Daniel-Loi/Spatial-Mapping-Embedded-System-/Keil_loid1/Main.c

/*  Time of Flight for 2DX4 -- Studio W8-0
Code written to support data collection from VL53L1X using the Ultra Light Driver.
I2C methods written based upon MSP432E4 Reference Manual Chapter 19.
Specific implementation was based upon format specified in VL53L1X.pdf pg19-21
Code organized according to en.STSW-IMG009\Example\Src\main.c

The VL53L1X is run with default firmware settings.


Written by Tom Doyle
Updated by  Hafez Mousavi Garmaroudi
Last Update: March 17, 2020

Last Update: March 03, 2022
Updated by Hafez Mousavi
__ the dev address can now be written in its original format.
Note: the functions  beginTxI2C and  beginRxI2C are modified in vl53l1_platform_2dx4.c file

 */
 # include <stdint.h>
 # include "tm4c1294ncpdt.h"
 # include "vl53l1x_api.h"
 # include "PLL.h"
 # include "SysTick.h"
 # include "uart.h"
 # include "onboardLEDs.h"

 # define I2C_MCS_ACK 0x00000008 // Data Acknowledge Enable
 # define I2C_MCS_DATACK 0x00000008 // Acknowledge Data
 # define I2C_MCS_ADRACK 0x00000004 // Acknowledge Address
 # define I2C_MCS_STOP 0x00000004 // Generate STOP
 # define I2C_MCS_START 0x00000002 // Generate START
 # define I2C_MCS_ERROR 0x00000002 // Error
 # define I2C_MCS_RUN 0x00000001 // I2C Master Enable
 # define I2C_MCS_BUSY 0x00000001 // I2C Busy
 # define I2C_MCR_MFE 0x00000010 // I2C Master Function Enable

 # define MAXRETRIES 5 // number of receive attempts before giving up
void I2C_Init(void) {
    SYSCTL_RCGCI2C_R |= SYSCTL_RCGCI2C_R0; // activate I2C0
    SYSCTL_RCGCGPIO_R |= SYSCTL_RCGCGPIO_R1; // activate port B
    while ((SYSCTL_PRGPIO_R & 0x0002) == 0) {}; // ready?

    GPIO_PORTB_AFSEL_R |= 0x0C; // 3) enable alt funct on PB2,3       0b00001100
    GPIO_PORTB_ODR_R |= 0x08; // 4) enable open drain on PB3 only

    GPIO_PORTB_DEN_R |= 0x0C; // 5) enable digital I/O on PB2,3
    //    GPIO_PORTB_AMSEL_R &= ~0x0C;          																// 7) disable analog functionality on PB2,3

    // 6) configure PB2,3 as I2C
    //  GPIO_PORTB_PCTL_R = (GPIO_PORTB_PCTL_R&0xFFFF00FF)+0x00003300;
    GPIO_PORTB_PCTL_R = (GPIO_PORTB_PCTL_R & 0xFFFF00FF) + 0x00002200; //TED
    I2C0_MCR_R = I2C_MCR_MFE; // 9) master function enable
    I2C0_MTPR_R = 0b0000000000000101000000000111011; // 8) configure for 100 kbps clock (added 8 clocks of glitch suppression ~50ns)
    //    I2C0_MTPR_R = 0x3B;                                        						// 8) configure for 100 kbps clock

}

//The VL53L1X needs to be reset using XSHUT.  We will use PG0
void PortG_Init(void) {
    //Use PortG0
    SYSCTL_RCGCGPIO_R |= SYSCTL_RCGCGPIO_R6; // activate clock for Port N
    while ((SYSCTL_PRGPIO_R & SYSCTL_PRGPIO_R6) == 0) {}; // allow time for clock to stabilize
    GPIO_PORTG_DIR_R &= 0x00; // make PG0 in (HiZ)
    GPIO_PORTG_AFSEL_R &= ~0x01; // disable alt funct on PG0
    GPIO_PORTG_DEN_R |= 0x01; // enable digital I/O on PG0
    // configure PG0 as GPIO
    //GPIO_PORTN_PCTL_R = (GPIO_PORTN_PCTL_R&0xFFFFFF00)+0x00000000;
    GPIO_PORTG_AMSEL_R &= ~0x01; // disable analog functionality on PN0

    return;
}

void PortH_Init(void) {
    //Use PORTH pins for output
    SYSCTL_RCGCGPIO_R |= SYSCTL_RCGCGPIO_R7; // activate clock for Port N
    while ((SYSCTL_PRGPIO_R & SYSCTL_PRGPIO_R7) == 0) {}; // allow time for clock to stabilize
    GPIO_PORTH_DIR_R |= 0xFF; // make PN0 out (PN0 built-in LED1)
    GPIO_PORTH_AFSEL_R &= ~0xFF; // disable alt funct on PN0
    GPIO_PORTH_DEN_R |= 0xFF; // enable digital I/O on PN0
    // configure PN1 as GPIO
    //GPIO_PORTH_PCTL_R = (GPIO_PORTH_PCTL_R&0xFFFFFF0F)+0x00000000;
    GPIO_PORTH_AMSEL_R &= ~0xFF; // disable analog functionality on PN0
    return;
}

//XSHUT     This pin is an active-low shutdown input;
//					the board pulls it up to VDD to enable the sensor by default.
//					Driving this pin low puts the sensor into hardware standby. This input is not level-shifted.
void VL53L1X_XSHUT(void) {
    GPIO_PORTG_DIR_R |= 0x01; // make PG0 out
    GPIO_PORTG_DATA_R &= 0b11111110; //PG0 = 0
    //FlashAllLEDs();
    SysTick_Wait10ms(10);
    GPIO_PORTG_DIR_R &= ~0x01; // make PG0 input (HiZ)

}


// Enable interrupts
void EnableInt(void)
{    __asm("    cpsie   i\n");
}

// Disable interrupts
void DisableInt(void)
{    __asm("    cpsid   i\n");
}

// Low power wait
void WaitForInt(void)
{    __asm("    wfi\n");
}

// global variable visible in Watch window of debugger
// increments at least once per button press
volatile unsigned long FallingEdges = 0;

// give clock to Port J and initalize as input GPIO
void PortJ_Init(void){
	SYSCTL_RCGCGPIO_R |= SYSCTL_RCGCGPIO_R8;					// activate clock for Port J
	while((SYSCTL_PRGPIO_R&SYSCTL_PRGPIO_R8) == 0){};	// allow time for clock to stabilize
  GPIO_PORTJ_DIR_R &= ~0x02;    										// make PJ1 in 
  GPIO_PORTJ_DEN_R |= 0x02;     										// enable digital I/O on PJ1
	
	GPIO_PORTJ_PCTL_R &= ~0x000000F0;	 								//  configure PJ1 as GPIO 
	GPIO_PORTJ_AMSEL_R &= ~0x02;											//  disable analog functionality on PJ1		
	GPIO_PORTJ_PUR_R |= 0x02;													//	enable weak pull up resistor
}

void PortM_Init(void){
	SYSCTL_RCGCGPIO_R |= SYSCTL_RCGCGPIO_R11;					// activate clock for Port P
	while((SYSCTL_PRGPIO_R&SYSCTL_PRGPIO_R11) == 0){};	// allow time for clock to stabilize
  GPIO_PORTM_DIR_R &= ~0x02;    										// make PM1 in 
  GPIO_PORTM_DEN_R |= 0x02;     										// enable digital I/O on PM1
	
	GPIO_PORTM_PCTL_R &= ~0x000000F0;	 								//  configure PM1 as GPIO 
	GPIO_PORTM_AMSEL_R &= ~0x02;											//  disable analog functionality on PM1		
	GPIO_PORTM_PUR_R |= 0x02;													//	enable weak pull up resistor
}


// Interrupt initialization for GPIO Port J IRQ# 51
void PortJ_Interrupt_Init(void){
	
	
		GPIO_PORTJ_IS_R = 0;     						// (Step 1) PJ1 is edge-sensitive 
		GPIO_PORTJ_IBE_R = 0;    						//     			PJ1 is not both edges 
		GPIO_PORTJ_IEV_R = 0;    						//     			PJ1 falling edge event 
		GPIO_PORTJ_ICR_R = 0x02;      			// 					clear interrupt flag by setting proper bit in ICR register
		GPIO_PORTJ_IM_R = 0x02;      				// 					arm interrupt on PJ1 by setting proper bit in IM register
    
		NVIC_EN1_R = 0x00080000;           // (Step 2) enable interrupt 51 in NVIC
	
		NVIC_PRI12_R = 0xA0000000; 					// (Step 4) set interrupt priority 5

		EnableInt();           							// (Step 3) Enable Global Interrupt. lets go!
}

void PortM_Interrupt_Init(void){
	
		GPIO_PORTM_IS_R = 0;     						// (Step 1) PP1 is edge-sensitive 
		GPIO_PORTM_IBE_R = 0;    						//     			PP1 is not both edges 
		GPIO_PORTM_IEV_R = 0;    						//     			PP1 falling edge event 
		GPIO_PORTM_ICR_R = 0x02;      			// 					clear interrupt flag by setting proper bit in ICR register
		GPIO_PORTM_IM_R = 0x02;      				// 					arm interrupt on PJ1 by setting proper bit in IM register
    
		NVIC_EN2_R = 0x00000100;           // (Step 2) enable interrupt 77 in NVIC
	
		NVIC_PRI18_R = 0x00080000; 					// (Step 4) set interrupt priority 4

		EnableInt();           							// (Step 3) Enable Global Interrupt. lets go!
}




//	(Step 5) IRQ Handler (Interrupt Service Routine).  
//  				This must be included and match interrupt naming convention
//	 				in startup_msp432e401y_uvision.s 
//					(Note - not the same as Valvano textbook).
uint16_t dev = 0x29; //address of the ToF sensor as an I2C slave peripheral
int status = 0;
uint8_t byteData, sensorState = 0, myByteArray[10] = {0xFF,0xFF,0xFF,0xFF,0xFF,0xFF,0xFF,0xFF,0xFF,0xFF},i = 0;
uint16_t wordData;
uint16_t Distance;
uint16_t SignalRate;
uint16_t AmbientRate;
uint16_t SpadNum;
uint8_t RangeStatus;
uint8_t dataReady;
uint8_t runToF = 1;
int cycle = 0;
int numPts = 32;
int temp;

void spin() {
    for (int i = 0; i < 512/numPts; i++) {
        GPIO_PORTH_DATA_R = 0b00001100;
        SysTick_Wait10ms(1);
        GPIO_PORTH_DATA_R = 0b00000110;
        SysTick_Wait10ms(1);
        GPIO_PORTH_DATA_R = 0b00000011;
        SysTick_Wait10ms(1);
        GPIO_PORTH_DATA_R = 0b00001001;
        SysTick_Wait10ms(1);
    }
}
void spinccw() {
    for (int i = 0; i < 512; i++) {
        GPIO_PORTH_DATA_R = 0b00001001;
        SysTick_Wait10ms(1);
        GPIO_PORTH_DATA_R = 0b00000011;
        SysTick_Wait10ms(1);
        GPIO_PORTH_DATA_R = 0b00000110;
        SysTick_Wait10ms(1);
        GPIO_PORTH_DATA_R = 0b00001100;
        SysTick_Wait10ms(1);
    }
}

void GPIOJ_IRQHandler(void){
	while (runToF) {
			status = VL53L1X_StartRanging(dev); // This function has to be called to enable the ranging
			while(cycle < numPts){
					
				for (int i = 0; i < 1; i++) {

						//wait until the ToF sensor's data is ready
						while (dataReady == 0) {
								status = VL53L1X_CheckForDataReady(dev,  & dataReady);
								VL53L1_WaitMs(dev, 5);
						}
						dataReady = 0;

						//read the data values from ToF sensor
						status = VL53L1X_GetRangeStatus(dev,  & RangeStatus);
						status = VL53L1X_GetDistance(dev,  & Distance); //The Measured Distance value
						//status = VL53L1X_GetSignalRate(dev,  & SignalRate);
						//status = VL53L1X_GetAmbientRate(dev,  & AmbientRate);
						//status = VL53L1X_GetSpadNb(dev,  & SpadNum);

						FlashLED3(1);

						status = VL53L1X_ClearInterrupt(dev); /* clear interrupt has to be called to enable next interrupt*/

						// print the resulted readings to UART
						sprintf(printf_buffer, "%u, %u \r\n", RangeStatus, Distance);
						UART_printf(printf_buffer);

						SysTick_Wait10ms(10);
						
				}
				spin();
				cycle++;
			}
			if(runToF == 1){
				status = VL53L1X_StopRanging(dev);
				spinccw();
				cycle = 0;
			}
  }
	GPIO_PORTJ_ICR_R = 0x02;      	// acknowledge flag by setting proper bit in ICR register
}

void GPIOM_IRQHandler(void){
	runToF = !runToF;
	if(runToF == 0)
	{
		status = VL53L1X_StopRanging(dev);
		temp = cycle;
		cycle = 1000;
	}
	else if(runToF == 1)
	{
		status = VL53L1X_StartRanging(dev); // This function has to be called to enable the ranging
		cycle = temp;
	}
	GPIO_PORTM_ICR_R = 0x02;      	// acknowledge flag by setting proper bit in ICR register
	
}

//*********************************************************************************************************
//*********************************************************************************************************
//***********					MAIN Function				*****************************************************************
//*********************************************************************************************************
//*********************************************************************************************************

int main(void) {


    //initialize
    PLL_Init();
    SysTick_Init();
    onboardLEDs_Init();
    I2C_Init();
    UART_Init();
    PortH_Init();
		PortJ_Init();							// Initialize the onboard push button on PJ1
	  PortM_Init();
		PortJ_Interrupt_Init();		// Initalize and configure the Interrupt on Port J
		PortM_Interrupt_Init();
		
    // hello world!
    UART_printf("Program Begins\r\n");
    int mynumber = 1;
    sprintf(printf_buffer, "2DX4 Program Studio Code %d\r\n", mynumber);
    UART_printf(printf_buffer);

    /* Those basic I2C read functions can be used to check your own I2C functions */
    status = VL53L1X_GetSensorId(dev,  & wordData);

    sprintf(printf_buffer, "(Model_ID, Module_Type)=0x%x\r\n", wordData);
    UART_printf(printf_buffer);

    // Booting ToF chip
    while (sensorState == 0) {
        status = VL53L1X_BootState(dev,  & sensorState);
        SysTick_Wait10ms(10);
    }
    FlashAllLEDs();
    UART_printf("ToF Chip Booted!\r\n Please Wait...\r\n");

    status = VL53L1X_ClearInterrupt(dev); /* clear interrupt has to be called to enable next interrupt*/

    /* This function must to be called to initialize the sensor with the default setting  */
    status = VL53L1X_SensorInit(dev);
    Status_Check("SensorInit", status);

    /* Optional functions to be used to change the main ranging parameters according the application requirements to get the best ranging performances */
    //  status = VL53L1X_SetDistanceMode(dev, 2); /* 1=short, 2=long */
    //  status = VL53L1X_SetTimingBudgetInMs(dev, 100); /* in ms possible values [20, 50, 100, 200, 500] */
    //  status = VL53L1X_SetInterMeasurementInMs(dev, 200); /* in ms, IM must be > = TB */


		while(1){							// Inside an infinite while loop, 
			WaitForInt();				// call WaitForInt() function to wait for interrupts
		}
		


}
